Jaden1717/fpga-dynamic-balancer-2026-public/report/readme.md

# 技术报告

[设计报告](design_report.md)涵盖背景与相关工作、软硬件划分、接口、算法、实验、优化前后对照、AI协作、技能提炼和完整复现步骤。

配套资料：[AI原文案例](../docs/ai_collaboration.md) · [实测数据索引](../docs/evidence.md) · [综合与实现报告](../build/reports/rebuild_20261102/readme.md)。

竞赛提交版已按正式模板定稿并导出PDF，对应源码提交 `634ea895f4255e5df4c2ddb73c13567538996d8c`。本目录维护完整技术正文和工程核查入口。
