Jaden1717/fpga-dynamic-balancer-2026-public/data/readme.md

# 实测数据与参考结果

| 目录 | 用途 |
|---|---|
| `physical/` | 按批次选取的原始文件、运行条件及实测输出 |
| `review/` | 独立整数核对、全部窗口统计及模型诊断 |
| `benchmarks/` | 软件准备优化的原始基线 |

优先阅读[证据索引](../docs/evidence.md)与[实验结果](../docs/results.md)，再按结论定位相应批次。

主要批次为固定C三次启停（2026-11-01）、第一份记录的8窗FPGA重放、加固后五状态及B0—A—B1（2026-11-02）。更早记录用于回归输入、模型演进和失败分析，不与最新安装状态混用。

公开版保留代表性样例，历史归档由团队保管。原字节证据和去除本机路径的副本分别列在[保留证据清单](../verification/path_migration_20261102.json)与[公开快照记录](../verification/public_snapshot.json)。
