Jaden1717/fpga-dynamic-balancer-2026-public/docs/readme.md

# 文档中心

| 阅读目的 | 文档 |
|---|---|
| 在PC复核结果 | [快速开始](quickstart.md) |
| 理解系统与数值约定 | [系统架构](architecture.md) |
| 接线、镜像与构建 | [硬件指南](hardware.md) |
| 在PYNQ运行 | [测量操作](measurement.md) |
| 查看实验与性能 | [实验结果](results.md) · [数据索引](evidence.md) |
| 阅读完整原理 | [技术报告](../report/design_report.md) |
| 开发与测试 | [开发指南](development.md) |
| 复用协作经验 | [AI案例](ai_collaboration.md) · [技能包](../skill/readme.md) |
| 核对工程适用范围 | [技术限制](limitations.md) · [指南对照](guide_compliance.md) |
| 核对文件与许可 | [路径映射](path_migration.md) · [许可说明](licensing.md) |
