Jaden1717/fpga-dynamic-balancer-2026-public/data/review/hx_reversible_20261102/readme.md

# 本轮B0—A—B1原件复核

已核对用户回传SHA，安全保全55个归档成员；保留3份完成与2份中断记录。12个有效原文件SHA和停止检查通过，从CSV重建全部24窗，独立整数点积及幅值与板端CPU参考一致。本轮无新增FPGA计算。

|状态|均值mg peak|窗口SD mg|窗口CV|RPM|
|---|---:|---:|---:|---:|
|01_reference_before|0.539167731|0.016015407|2.9704%|1714.256|
|02_trial_A_powered_01|0.527831030|0.015337544|2.9058%|1715.839|
|03_reference_after_e0fc472e-4a8c-4d07-9a12-7a0c67764bd2|0.722605013|0.021967357|3.0400%|1712.446|

A相对前参考变化-2.1026%，后参考相对前参考变化34.0223%。本轮首尾参考未恢复，不足以识别胶带净作用。各条低CV不代表跨记录均值一致。

本轮三份同boot且配置一致；本轮boot_id与队友此前三次空转不同。用户此前声明未重启与实际boot身份存在待澄清差异，不能以此推断重启导致幅值变化；三份当前记录同boot，因此跨boot不能解释本轮首尾变化。

中间两份忘通电/手动中断记录完整保留，脉冲均为0，不混入旋转分析。暂不追加采集，也不替换基线或输出修正克数。全部8窗保留；连续窗可能相关，SD/CV不是仪器精度、均值置信区间或长期可重复性界限。
