Jaden1717/fpga-dynamic-balancer-2026-public/docs/licensing.md

# 许可与公开范围

团队原创代码与文档适用 [MIT 许可证](../license)。第三方依赖与工具仍按各自条款使用，来源见[第三方说明](../third_party_notices.md)。公开的实测样例和 AI 节选供核查及复现使用，来源说明和原件身份随样例保存。

公开仓库由经过筛选的源码树初始化。原厂板卡文件按需下载，封存镜像原件及其旧 Git 历史由团队保管。带本机路径的历史记录保留于私有归档。必要测试样例以去除本机路径的副本提供，字节身份在[发布记录](../verification/public_snapshot.json)中分别列出。
