Jaden1717/fpga-dynamic-balancer-2026-public/docs/limitations.md

# 已知限制与后续研究

| 范围 | 当前边界 | 后续证据 |
|---|---|---|
| 配重 | 无已验收修正质量、最优角度、独立减振闭环 | 已知质量和定位几何、稳定参考、模型闭合及独立验收 |
| 精度 | 算术一致不等于绝对精度 | 传感链校准及误差预算 |
| 相位 | 数学编码已核对，绝对物理相位／方向映射未标定 | 零位与方向标定 |
| 重复性 | 固定C、n=3、同boot与安装 | 跨批次、跨安装、长期验证 |
| 原因 | 首尾参考变化的贡献未隔离 | 能区分安装、初始化、热状态和环境的有限实验 |
| 性能 | 分时overlay，PS准备和传输开销显著 | 受控基线与集成设计验证 |
| 实时／界面 | 可运行命令行流程；未验收连续XYZ和完整产品GUI | 新实现及运行证据 |
| 抗混叠 | 控制本次128→64角域降采样 | 前级频谱、传感链和插值评估 |
| 工具链 | 两套新构建已完成，DRC及PS预置警告保留 | 新镜像板验、外部接口完整签核，见[构建记录](../verification/hardware_rebuild_20261102.json) |

后续按一次明确问题设定协议，保留全部窗口及失败；不通过挑轴、挑窗、换基线或不断补采制造通过。
