Jaden1717/fpga-dynamic-balancer-2026-public/docs/path_migration.md

# 文件路径与历史证据

公开版采用小写 ASCII 路径。[保留证据清单](../verification/path_migration_20261102.json)记录保留文件的原始 SHA256，[公开快照记录](../verification/public_snapshot.json)单列去除本机路径的样例副本及其原件 SHA256。用[当前树清单](../sha256sums.txt)核对公开版本的实际字节。

板卡定义与图片作为[外部依赖](../third_party/pynq_z2_board_files.json)按需下载，PS7 配置在构建机器本地生成。技能包通过导出命令在 work 下生成运行时 SKILL.md。
