Jaden1717/fpga-dynamic-balancer-2026-public/skill/pynq_evidence_workflow/skill.md

---
name: pynq-evidence-workflow
description: Preserve and independently validate input-bound evidence in PS/PL capture and compute workflows, including overlay replacement and derived-result consistency.
---

# PYNQ证据工作流

## 使用范围
用于PS通过Python配置PL、读取FIFO或MMIO、处理采集文件及比较硬件结果的测量/信号处理原型。可迁移的是验证顺序与失败定位方法；各工程必须替换时钟、寄存器ABI、输入范围、数量和误差约定。没有跨板通用驱动或跨板实测声明。

先区分四个结论：文件/传输完整；同输入算术一致；物理量解释可信；应用目标达成。前一项通过不自动推出后一项。

## 开始时填入的契约
记录目标板卡、overlay和驱动身份；采样与事件时钟、计数器位宽与重置语义；输入数值范围、单位和样本数；输出寄存器量化与相位语义；参考模型和允许误差的依据。对实际来源无法由软件验证的条件标明由操作者声明，不从文件夹名字猜工况。

## 工作步骤
1. 在同一overlay内结束采集，先停止源，再处理在途数据、排空FIFO并冻结计数。保存原始数据、完成状态、损失计数和只读停止观察；失败也保留部分数据。
2. 校验计数、时基、单位和配置。生成文件身份清单，原始文件冻结后不覆写。准备阶段开始/结束重新核对来源，批处理上下文仅在单次调用内共享。
3. 保存实际输入，并把其内容哈希写入结果。硬件计算前检查ABI与完整样本数；输出寄存器在ACK之前一次性读取。超时/异常清理在途计算，错误不能生成成功结果。
4. 由独立参考从同一实际输入计算结果，避免比较不同窗口或先相信嵌入的reference。先对整数/IQ，再按契约比较极坐标结果。允许误差需适配目标量化，不能照抄本项目数值。
5. 从已验证寄存器派生显示量和统计量。若结果文件另存浮点幅相，检查其与寄存器的一致性及有限性，防止“寄存器正确、展示却错误”。
6. 若overlay会替换，切换前结束旧任务并冻结证据；切换后重建对象，不访问旧MMIO。用独立生命周期日志解释采集与计算两阶段。
7. 分别记录读取/准备、overlay下载、传输、计算等待与文件写入时间。循环周期、MMIO墙钟、CPU准备和端到端时间不能混称加速比。
8. 同时报告数值、绝对波动、相对波动、参考阈值来源和用途。把工程参考当作诊断信息；新增试验必须说明它能区分哪个假设，不能为了越过一条自设线不断重采。

## 失败定位案例
- 输出目录已存在：保留原件，用新输出路径；不能把拒绝覆盖误解为首次运行没成功。
- Linux清单含CRLF：先确认是清单行尾造成文件名多出CR，再以去CR视图校验；不篡改源文件内容来追哈希。
- 停止快照只有实时状态位变化：必须先读ABI，分离实时引脚与冻结计数；仅对已知实时位作解释，其余状态和数据损失仍核对。
- CV接近参考线：先看信号量级、窗口相关性、背景与用途；幅值CV也可能掩盖相位交替，补充复数稳定性描述。
- 标量值可视化看似正确：仍要检查实际输入绑定；图表、README声明或合成曲线不能替代对应板端原始结果。
- 默认测试误收历史副本：把正式测试发现路径写清，归档中的同名模块不参与当前套件。保留首次失败日志。

## 本项目的已验证案例与边界
验收记录见data/review/hx_audit_20261029及report/project_reaudit_20261029.md：32个历史FPGA窗口重新通过，浮点字段篡改反例先失败后修复，完整338项及新目录338项均通过。批处理17到1次解析的PC测量不能外推板端速度。

若在当前仓库复演，回归所需fixture已随工程保留。从根目录运行`python -B -m pytest -q -p no:cacheprovider --basetemp work/pytest-skill tests tools/controlled_trial/test_finish_control.py`，历史恢复报告只作溯源。换项目时接入自己的黄金参考；本项目verify_order1x不是通用ABI校验器。模型线性、安装、TACH物理来源、试重质量与实际修正效果仍需专门证据。
