Jaden1717/fpga-dynamic-balancer-2026-public/data/review/hx_audit_20261029/algorithm_comparison.png

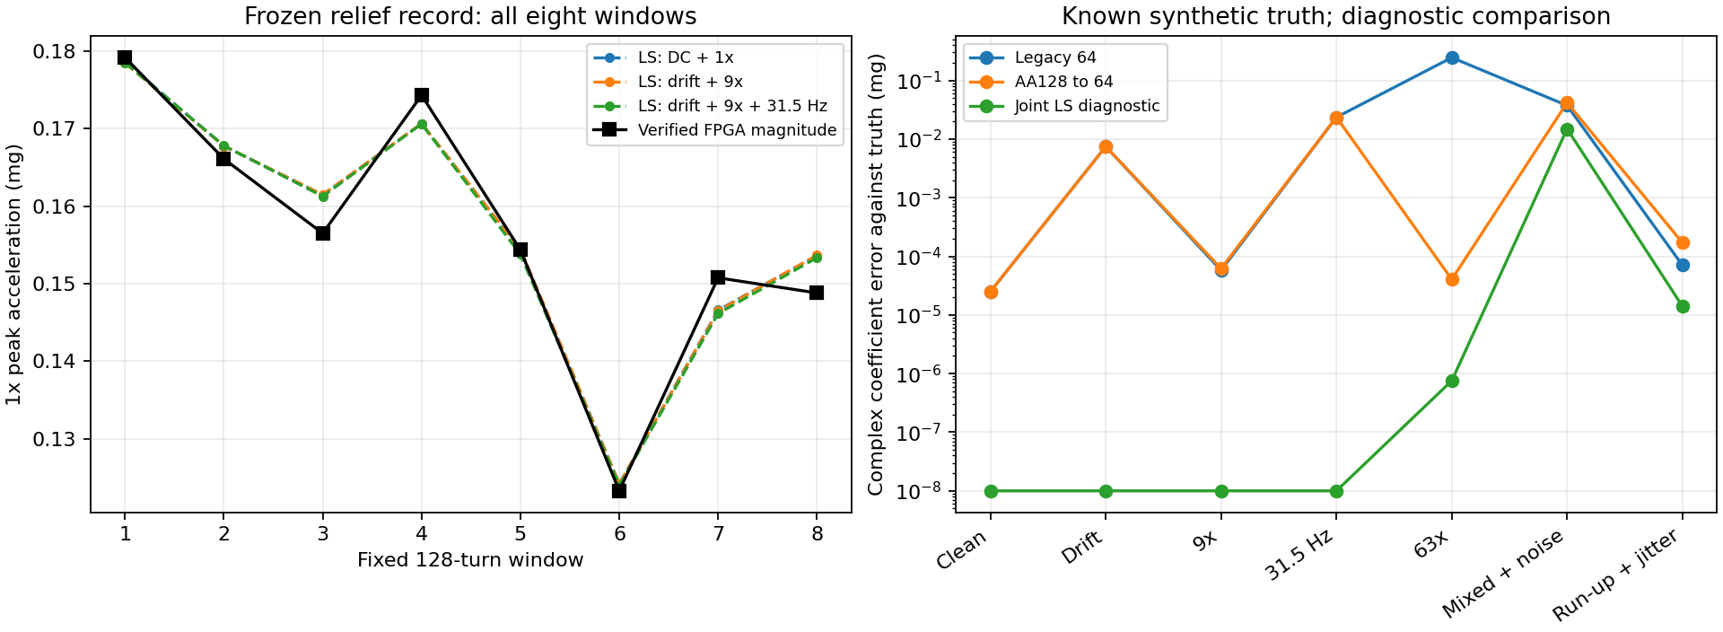
data/review/hx_audit_20261029/algorithm_comparison.png
