Jaden1717/fpga-dynamic-balancer-2026-public/data/review/hx_fixed_c_reference_20261101/fixed_c_three_starts.png

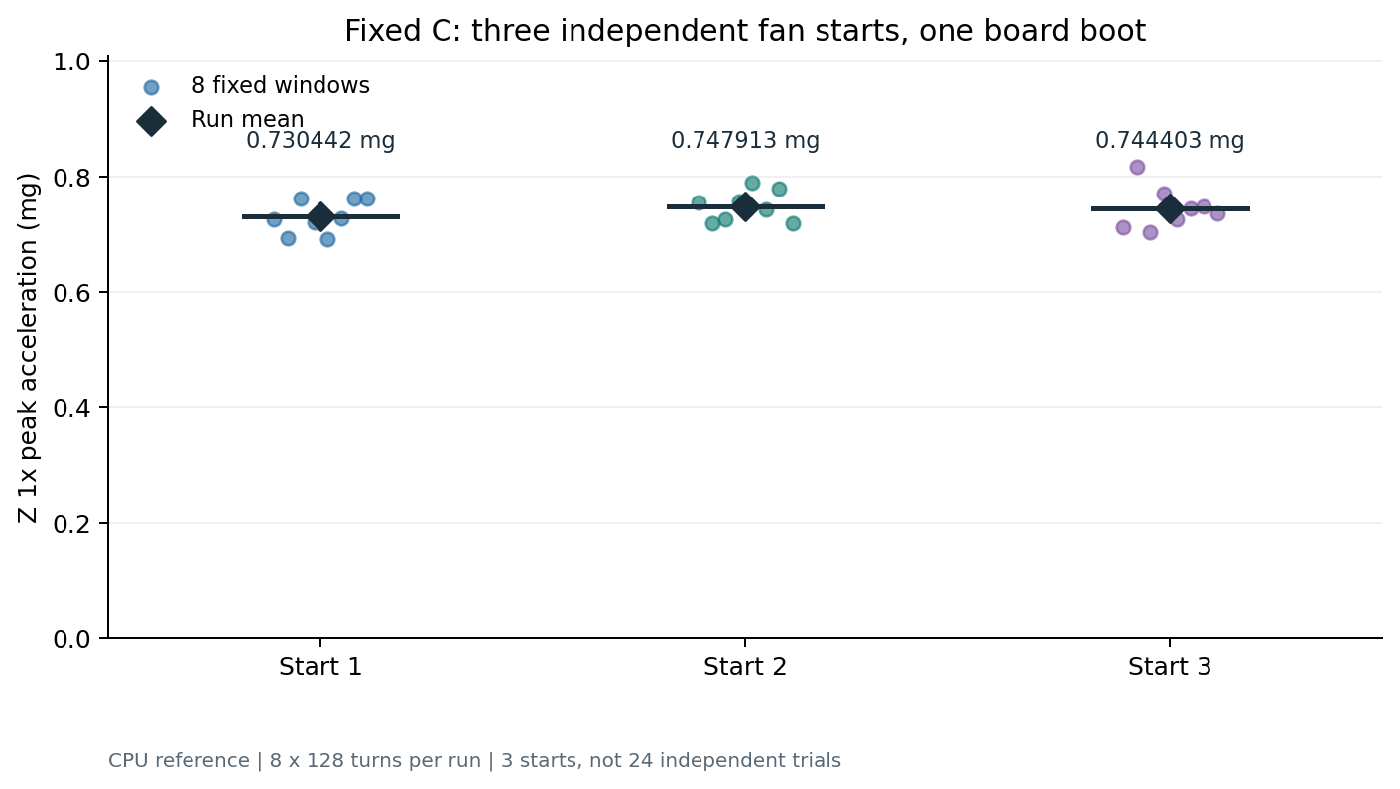
data/review/hx_fixed_c_reference_20261101/fixed_c_three_starts.png
