Jaden1717/fpga-dynamic-balancer-2026-public/verification/guide_remediation_tests_20261102.txt

........................................................................ [ 17%]
........................................................................ [ 35%]
........................................................................ [ 52%]
........................................................................ [ 70%]
........................................................................ [ 88%]
.................................................                        [100%]
409 passed in 43.18s
