Jaden1717/fpga-dynamic-balancer-2026-public/verification/readme.md

# 验证记录

| 文件 | 说明 |
|---|---|
| [publication_tests.txt](publication_tests.txt) | 竞赛工程的软件回归历史日志 |
| [hardware_rebuild_20261102.json](hardware_rebuild_20261102.json) | 两套Vivado构建的输入、报告和输出身份 |
| [path_migration_20261102.json](path_migration_20261102.json) | 公开版保留原件的路径与 SHA256 |
| [github_delivery_tests_20261102.txt](github_delivery_tests_20261102.txt) | 整理前400项软件回归历史记录 |
| [guide_remediation_tests_20261102.txt](guide_remediation_tests_20261102.txt) | 增加发布工具后的409项回归历史记录 |

实时CI状态见[GitHub Actions](https://github.com/Jaden1717/fpga-dynamic-balancer-2026-public/actions)。历史日志不代替当前版本的实际检查。
