Jaden1717/fpga-dynamic-balancer-2026-public/verification/github_delivery_tests_20261102.txt

........................................................................ [ 18%]
........................................................................ [ 36%]
........................................................................ [ 54%]
........................................................................ [ 72%]
........................................................................ [ 90%]
........................................                                 [100%]
400 passed in 32.86s
