Jaden1717/fpga-dynamic-balancer-2026-public/verification/publication_tests.txt

........................................................................ [ 17%]
........................................................................ [ 35%]
........................................................................ [ 52%]
........................................................................ [ 70%]
........................................................................ [ 87%]
..................................................                       [100%]
410 passed in 32.10s
