Jaden1717/fpga-dynamic-balancer-2026-public/tests/fixtures/rtl_capture/pulses.csv

pulse_count | ticks
1 | 2305843009214193937
2 | 2305843009218193937
3 | 2305843009222193937
