Jaden1717/fpga-dynamic-balancer-2026-public/tests/fixtures/rtl_capture/samples.csv

frame_id | ticks | x_raw | y_raw | z_raw
0 | 2305843009213769034 | 5067 | -19996 | 256000
1 | 2305843009213794034 | 5092 | -19995 | 256000
2 | 2305843009213819034 | 5109 | -19994 | 256000
3 | 2305843009213844034 | 5118 | -19993 | 256000
4 | 2305843009213869034 | 5119 | -19992 | 256000
5 | 2305843009213894034 | 5112 | -19991 | 256000
6 | 2305843009213919034 | 5098 | -19990 | 256000
7 | 2305843009213944034 | 5076 | -19989 | 256000
8 | 2305843009213969034 | 5045 | -19988 | 256000
9 | 2305843009213994034 | 5007 | -19987 | 256000
10 | 2305843009214019034 | 4962 | -19986 | 256000
11 | 2305843009214044034 | 4908 | -19985 | 256000
12 | 2305843009214069034 | 4848 | -19984 | 256000
13 | 2305843009214094034 | 4779 | -19983 | 256000
14 | 2305843009214119034 | 4703 | -19982 | 256000
15 | 2305843009214144034 | 4620 | -19981 | 256000
16 | 2305843009214169034 | 4530 | -19980 | 256000
17 | 2305843009214194034 | 4433 | -19979 | 256000
18 | 2305843009214219034 | 4329 | -19978 | 256000
19 | 2305843009214244034 | 4219 | -19977 | 256000
20 | 2305843009214269034 | 4101 | -19976 | 256000
21 | 2305843009214294034 | 3978 | -19975 | 256000
22 | 2305843009214319034 | 3848 | -19974 | 256000
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
