Jaden1717/fpga-dynamic-balancer-2026-public/data/review/hx_control_result_20261101/five_state_results.csv

state | mean_peak_mg | window_sd_mg | within_record_cv | rpm_median | direct_ls_mean_peak_mg | dc_x_g | dc_y_g | dc_z_g | sample_count | pulse_count | boot_id
01_reference_before | 0.4068953781045108 | 0.029361445752497738 | 0.07215969345554048 | 1746.036896429248 | 0.40788909211289937 | -0.03747045743453885 | 0.007737329128876444 | 1.014400629514596 | 159102 | 2329 | 4cc2d7db-3f1e-41be-9dcf-93a405b66244
02_trial_000 | 1.1890255787488337 | 0.012293897044856372 | 0.010339472307898346 | 1747.4744988861867 | 1.189982643357777 | -0.04103284125149282 | 0.006936401722437852 | 1.0142567110796614 | 159095 | 2329 | 4cc2d7db-3f1e-41be-9dcf-93a405b66244
03_trial_120 | 0.20020172864438904 | 0.013033819233070775 | 0.06510343003192678 | 1745.9418854513656 | 0.2006936059320507 | -0.04914473307389878 | 0.007183478892068311 | 1.013879231574411 | 159096 | 2329 | 4cc2d7db-3f1e-41be-9dcf-93a405b66244
04_trial_240 | 1.3107276128312704 | 0.023295541879778756 | 0.017772984754214974 | 1748.961881813109 | 1.3099388490167585 | -0.050982026044449506 | 0.007886425937784831 | 1.0137723814116668 | 159085 | 2331 | 4cc2d7db-3f1e-41be-9dcf-93a405b66244
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
