Jaden1717/fpga-dynamic-balancer-2026-public/data/review/hx_fixed_c_reference_20261101/three_start_results.csv

run | mean_peak_mg | within_record_sd_mg | within_record_cv | rpm_median | sample_count | pulse_count | boot_id | initialization_id | full_pipeline_wall_seconds | analysis_wall_seconds
1 | 0.7304422256132868 | 0.029323242378690096 | 0.04014450609570114 | 1713.9852771521823 | 159103 | 2284 | 4fc7886f-5fdf-4d37-90fa-3f885a935e8b | 447f1ac8-af5c-4737-924a-28a02607b180 | 108.207027802 | 51.82011164000002
2 | 0.7479127157263834 | 0.026919238639443177 | 0.03599248692181792 | 1720.065379685144 | 159107 | 2293 | 4fc7886f-5fdf-4d37-90fa-3f885a935e8b | 0c656f7e-9cfa-4c5c-a24b-a4be521eca9a | 106.89360862199999 | 50.74635316199999
3 | 0.7444032825955718 | 0.03580250283250176 | 0.048095573554789085 | 1721.5536218046414 | 159097 | 2294 | 4fc7886f-5fdf-4d37-90fa-3f885a935e8b | b0117c21-a9a1-447a-a87d-a5e6ba131127 | 107.381778898 | 51.306765842999994
