Jaden1717/fpga-dynamic-balancer-2026-public/data/review/hx_fpga_replay_20261101/window_results.csv

start_turn | accepted_words | real_q8 | imag_q8 | magnitude_q8 | magnitude_error_q8 | phase_error_deg | fpga_peak_mg | cpu_peak_mg | driver_wall_s | feed_wall_s | result_wait_wall_s | ack_wall_s
0 | 8192 | -47563 | 892 | 47571 | 0 | 4.526227712631226e-06 | 0.7258758544921875 | 0.7258814023050795 | 0.585746663000009 | 0.585174084999835 | 4.1551000094841584e-05 | 0.00033362399994985026
128 | 8192 | -45326 | 1790 | 45361 | 0 | 2.430751919746399e-06 | 0.6921539306640625 | 0.6921589856808238 | 0.5582725589999882 | 0.5577521899999738 | 3.9077000110410154e-05 | 0.00032288600004903856
256 | 8192 | -49931 | 240 | 49932 | 0 | 4.945322871208191e-06 | 0.76190185546875 | 0.7618953978370202 | 0.5517831619999924 | 0.5512639070000205 | 3.916299988304672e-05 | 0.00032442400015497697
384 | 8192 | -47231 | -1604 | 47258 | 0 | 1.4249235391616821e-06 | 0.721099853515625 | 0.7211033427387209 | 0.5542677900000399 | 0.5537415250000777 | 3.895999998348998e-05 | 0.000331156999891391
512 | 8192 | -45312 | -654 | 45317 | 0 | 3.1013041734695435e-06 | 0.6914825439453125 | 0.6914782628041488 | 0.5572289280000859 | 0.5567024669999228 | 4.034500011584896e-05 | 0.0003268609998485772
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
