Jaden1717/fpga-dynamic-balancer-2026-public/data/review/hx_control_result_20261101/five_state_control.png

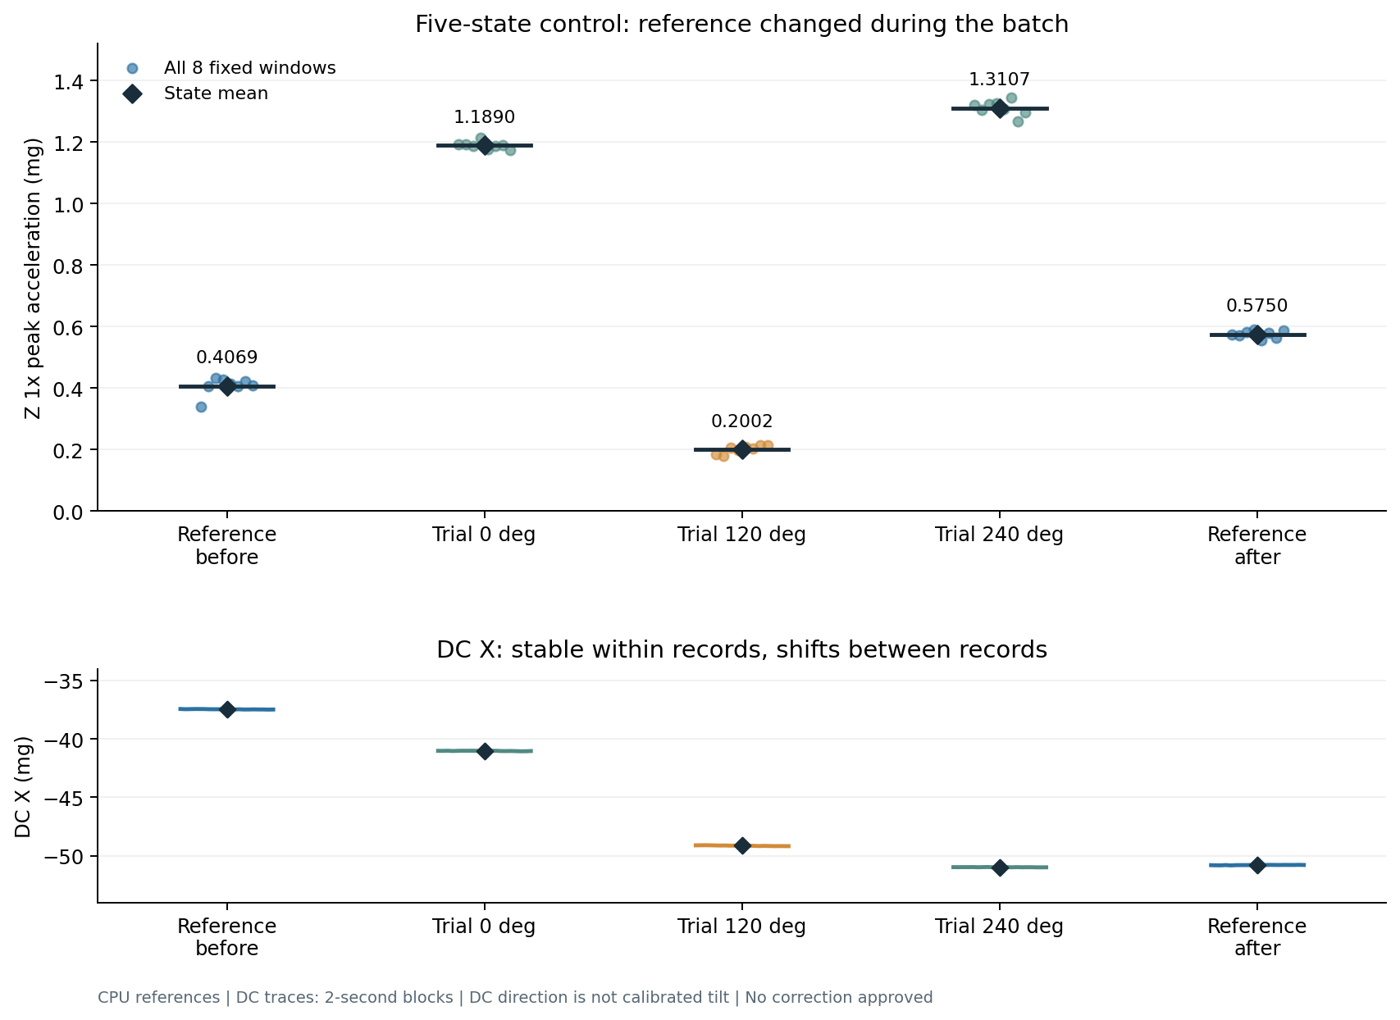
data/review/hx_control_result_20261101/five_state_control.png
