Jaden1717/fpga-dynamic-balancer-2026-public/changelog.md

# 变更记录

## 2026-11-02

- 完成英文小写路径适配，并以SHA256记录历史来源。
- 提供双overlay构建、依赖校验、技术报告和AI协作案例。
- 整理项目首页、文档导航和可复现的测试入口。
- 新增Windows/Linux路径与链接检查；固定测试输入归入`tests/fixtures/`。

历史工程提交与原始实测记录保留在Git历史和数据目录中。
